hoijui/KLOR/case/README.md

# KLOR CASE FILES

First you need to decide if you plan to use a stacked acrylic case or a 3D printed case (which also contains acrylic parts).\
You can click on the image left for the acrylic case and on the image right for the 3D printed case.

[stacked acrylic case](../case/acrylic/)
[3D printed case](../case/3DP/)
