hoijui/KLOR/knob/README.md

# KLOR KNOB

This is the EC11 encoder knob for the KLOR. You should be able to print it in FDM, but for best results consider to print it in SLA or MJF.\
I can recommend to get it printed at [JLCPCB](https://jlcpcb.com/)

KLOTZ knob

Here you can see it printed in black resin (left) and MJF nylon (right).

KLOTZ knob materials
