hoijui/KLOR/case/3DP/README.md

# KLOR 3DP CASE FILES

Next you need to decide which layout you want to use. 

[polydactyl](../../case/3DP/polydactyl/)
[konrad](../../case/3DP/konrad/)
[yubitsume](../../case/3DP/yubitsume/)
[saegewerk](../../case/3DP/saegewerk/)
