hoijui/KLOR/case/acrylic/README.md

# KLOR ACRYLIC CASE FILES

Next you need to decide which layout you want to use. 

[polydactyl](../../case/acrylic/polydactyl/)
[konrad](../../case/acrylic/konrad/)
[yubitsume](../../case/acrylic/yubitsume/)
[saegewerk](../../case/acrylic/saegewerk/)
