hoijui/KLOR/(commit log)

2025-01-20 git ignore build dir and KiCad temporary files
2025-01-20 PCB/README: Cleanup
2025-01-20 PCB: Update to KiCad 8 & apply some hoijui changes
2025-01-20 PCB: hoijui meta-text adjustments
